JensMakerAdventures/FidgetSpinnerInstrument/README.md

# Arduino fidget spinner instrument

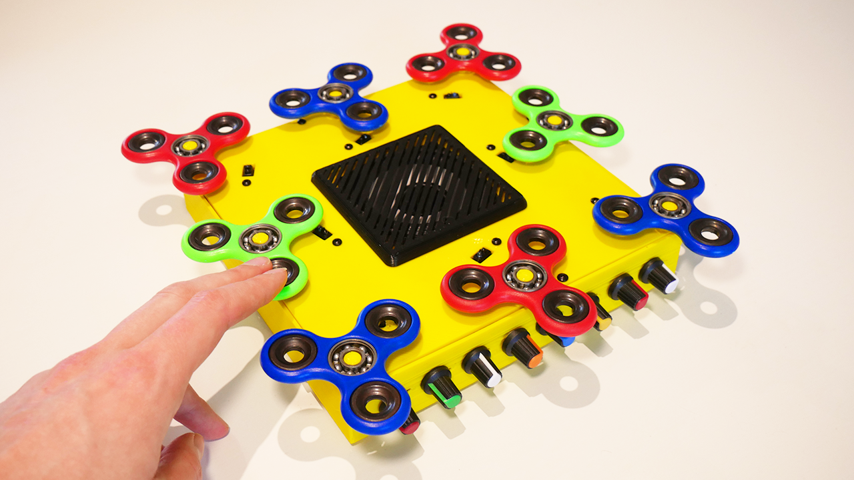
[picture p1: Thumbnail_V1.png]
Fidget spinner instrument

## YouTube video
https://youtu.be/xIgIhpeJyNA

## Electrical Diagram
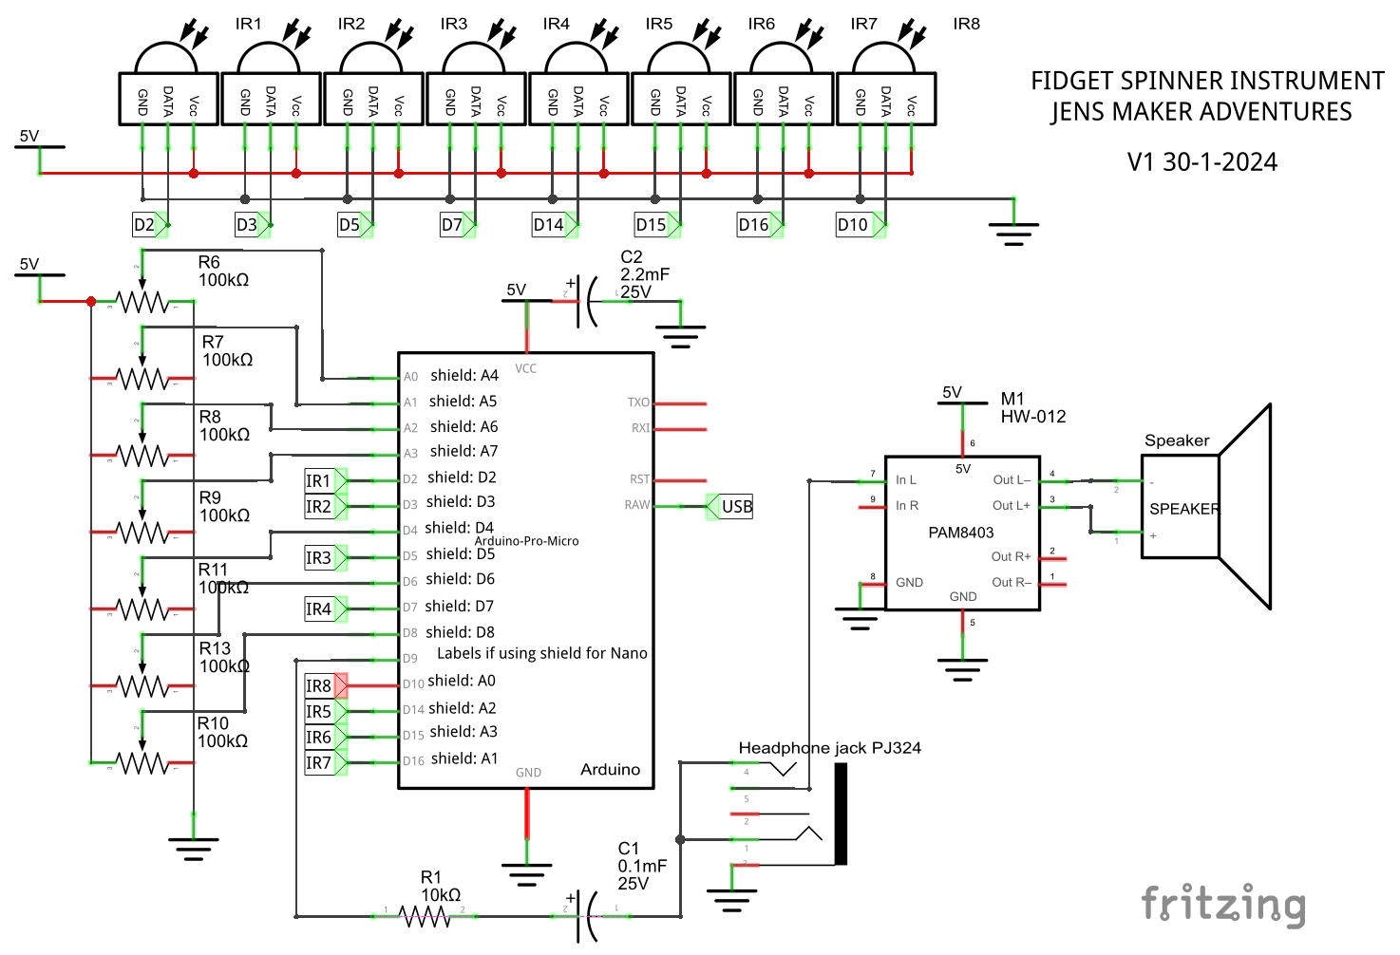
[picture p2: FidgetSpinnerSynthV1_schem.png]
Electrical diagram


## CAD files
https://www.thingiverse.com/thing:6460128
https://www.printables.com/model/744540-fidget-spinner-arduino-instrument

## Parts list
- Fidget spinners Dutch craigslist €25,00 (48 pieces of which 8 were broken)

- Potmeter cables: 10PCS 2.54MM 30CM 300MM Dupont Line Single Female 2P 3 4 5 6 7 8 9 10 12 Pin connector JUMPER CABLE WIRE FOR PCB Diy for Arduino - Single Female 3P €4,09
https://www.aliexpress.com/item/1005006060326696.html

- Potmeters: 100pcs WH148 Linear Potentiometer 15mm Shaft With Nuts And Washers 3pin WH148 B1K B2K B5K B10K B20K B50K B100K B250K B500K B1M - 100K Ohm €13,00 (100 pieces)
https://www.aliexpress.com/item/1005005617432938.html

- NANO I/O IO Expansion Sensor Shield Module For Arduino R3 Nano V3.0 3.0 Controller Compatible Board I2C PWM Interface 3.3V €2,31
https://www.aliexpress.com/item/1005001580331597.html

- PAM8403 module Super digital amplifier board 2 * 3W D Class digital amplifier board efficient switch potentiometer - Color: PAM8403 tuning €2,00
https://www.aliexpress.com/item/1005003708152065.html

- TCRT5000 3PIN Tracking Module IR Infrared Line Reflection Track Follower Sensor TCRT5000 Obstacle Avoidanc For Arduino - Color: 10pcs €4,86
https://www.aliexpress.com/item/1005003297744025.html

- 30PCS/lot WH148 Potentiometer Knob Kit Plastic Knobs Cap 6mm Shaft Hole AG2 Yellow Orange Blue White Red 5value*6PCS=30PCS €2,39
https://www.aliexpress.com/item/4000926690758.html

- AIYIMA 2Pcs 3Inch Audio Porble Speaker 4Ohm 5W DIY External Magnetic HiFi Full Range Speaker Horn Stereo Woofer Loudspeaker €8,06 (2 pieces)
https://www.aliexpress.com/item/32716065547.html

- 5/10 PCS Stereo Headphone Jack Socket PJ324 PJ324M 5 Pin 3.5mm Audio Jack Socket for Headphone With Nut PJ-324M PJ-324 - Color: PJ324M - Package: 10pcs €3,60 (10 pieces)
https://www.aliexpress.com/item/1005002954077817.html

- New Pro Micro for arduino ATmega32U4 5V/16MHz Module with 2 row pin header For Leonardo in stock . best quality - Color: TYPE-C €5,59
https://www.aliexpress.com/item/32846843498.html

- Toocki 3A USB Type C Cable Fast Charging QC 3.0 Data Cable For Samsung Xiaomi Huawei P30 USB A To USB C Cable 2M - Color: Black, 2m €2,24
https://www.aliexpress.com/item/1005005862432855.html

- 10PCS 2.54MM Pitch Wire Dupont Line Female to Female 1P2 3 4 5 6 Pin Dupont cable connector JUMPER CABLE WIRE FOR PCB 3D Printer - Package: Lengh 20CM - Pins: 3Pin €4,50 (10 pieces)
https://www.aliexpress.com/item/1005003638697583.html

- Uni-Fine Elastic Buffer, Transparent Furniture Buffer Rubber Buffer Self-Adhesive Protective Buffer Stopper Stop Damper Door Buffer Pads Buffer Furniture 22 mm - 22 * 5 mm(20 Stück) €5,99 (20 pieces) https://www.amazon.nl/dp/B0CDVWKYM1?ref=ppx_yo2ov_dt_b_product_details&language=en_GB&th=1

- 3D print filament eSun PLA+ yellow bottom frame 150 grams, top frame 140 grams and grille 16 grams. Total 300 grams, around ⅓ spool so around € 10,-.

- Not added here are 3D printer costs, wires, heatshrink, nuts, bolts, threaded inserts, electricity, soldering tin, resistors/capacitors, etc.
