JensMakerAdventures/FidgetSpinnerInstrument/(commit log)

2023-12-16 Update FidgetSpinnerSynth.ino
    Tweaked ADSR a bit and fixed bug for changing synthType
    [FidgetSpinnerSynth.ino]
2023-12-21 Update FidgetSpinnerSynth.ino
    Fixed bug where case statement wasn't followed correctly. Added working arp and mode and root note increment commands
    [FidgetSpinnerSynth.ino]
2023-12-21 Update FidgetSpinnerSynth.ino
    removed some print statements and added gain to output for adsr
2023-12-22 Update FidgetSpinnerSynth.ino
    Fix nasty bug where map() was used out of boundaries and clean up use of Serial.println()
    [FidgetSpinnerSynth.ino]
2023-12-24 Update FidgetSpinnerSynth.ino
    Fix nasty bug. mtof() function can only handle higher values correctly. added prescale to avoid
    [FidgetSpinnerSynth.ino]
2023-12-24 Update FidgetSpinnerSynth.ino
    Added each spinner playing it's own note in arp, fixed ugly bug in speed calculation
    [FidgetSpinnerSynth.ino]
2024-01-20 Update FidgetSpinnerSynth.ino
    Added potmeter filtering and hysterisis
2024-01-20 Update FidgetSpinnerSynth.ino
    Added basis for FX distortion, filtering and glitch
    [FidgetSpinnerSynth.ino]
2024-01-23 Update FidgetSpinnerSynth.ino
    Start support for multi notes, doesn't work yet
    [FidgetSpinnerSynth.ino]
2024-01-23 Update FidgetSpinnerSynth.ino
    Added tremolo, fixed some effects.
    [FidgetSpinnerSynth.ino]
2024-01-23 Update FidgetSpinnerSynth.ino
    Added some FX for multi notes, glitch and warp don't work yet.
    [FidgetSpinnerSynth.ino]
2024-01-24 Update FidgetSpinnerSynth.ino
    Stopping multi note now possible even when yuou switch key
2024-01-24 Update FidgetSpinnerSynth.ino
    Fixed potmeter ranges manually and refactored arpType into playStyle naming
    [FidgetSpinnerSynth.ino]
2024-01-24 Update FidgetSpinnerSynth.ino
    Fixed nasty bug, multi chord note memory made simpler
    [FidgetSpinnerSynth.ino]
2024-01-29 Update FidgetSpinnerSynth.ino
    Reenable midi CC, remove bug where the last stopped note was stopped a million times in a row
    [FidgetSpinnerSynth.ino]
